Corvus006/JIF_Robot/paper/pictures/SchaltplanUpdate.png

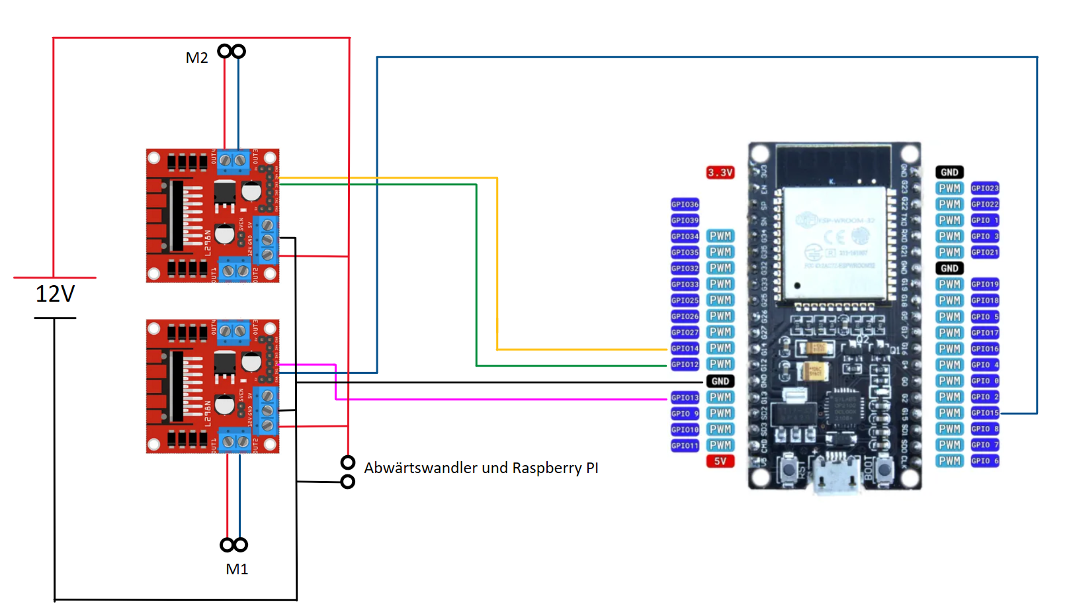
paper/pictures/SchaltplanUpdate.png
