Corvus006/JIF_Robot/paper/pictures/Schaltplan.png

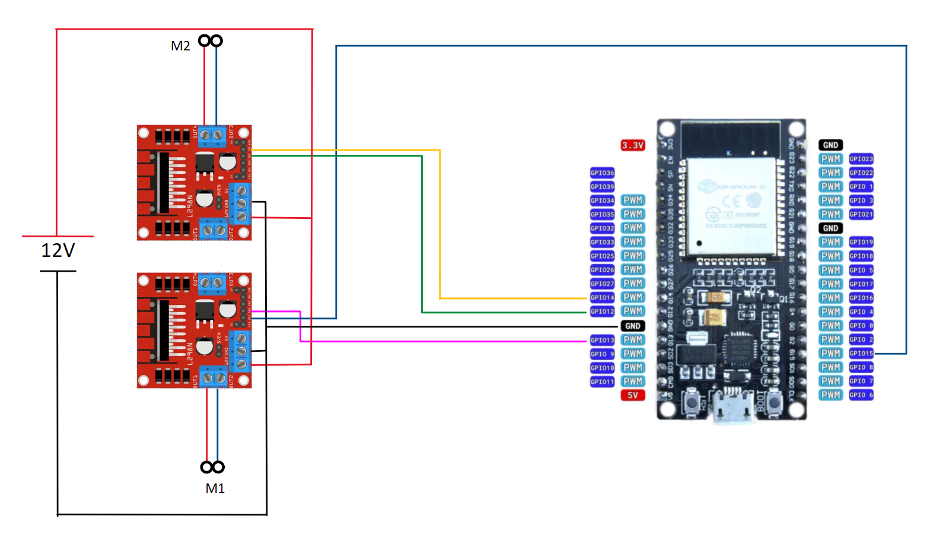
paper/pictures/Schaltplan.png
