Corvus006/JIF_Robot/CAD/3D Printable JIF- RC Tank v7.step

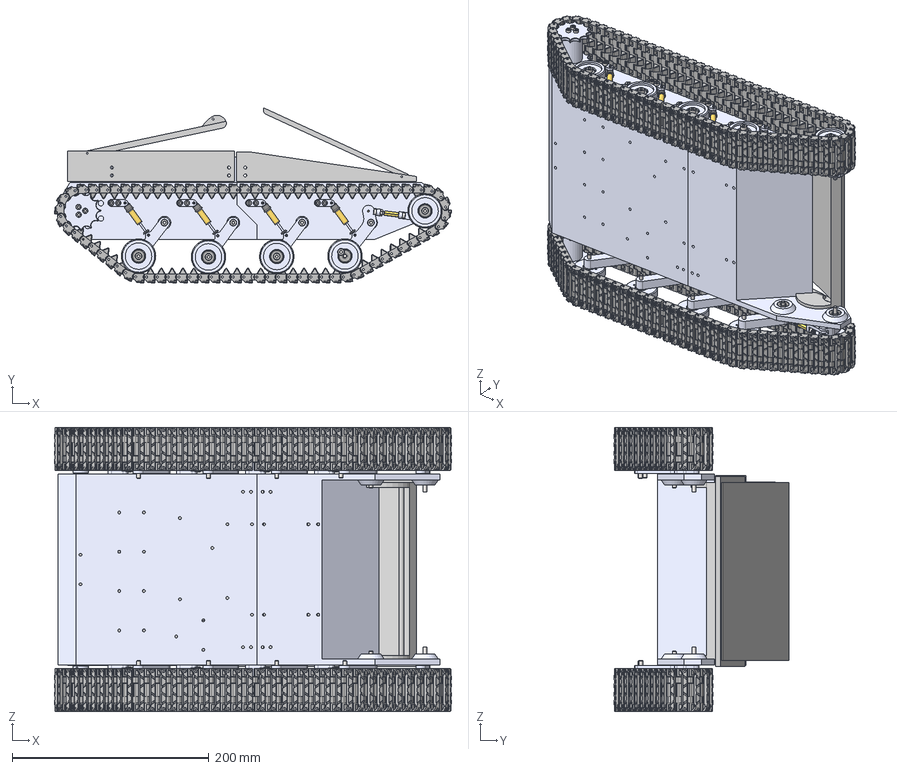
[picture p5: CAD file, 2024-01-28]
CAD/3D Printable JIF- RC Tank v7.step
403.7 x 178.2 x 289.0 mm
Road wheel arm 1r1 x 2
Shock Absorber - part 1r1 x 8
Shock Absorber - part 2r1 x 8
Bracket for Shock Absorberr1 x 8
Road wheel armr1 x 6
Track v3r1 x 158
Ball Bearing- 6x13x5mm h1r1_Ball Bearing 608 - 8x22x7mm x 6
DIN 912 M4 x 25 --- 25N_DIN 912 M4 x 25 --- 25N x 10
DIN 912 M3 x 20 --- 20N_DIN 912 M3 x 20 --- 20N x 22
DIN 912 M1.4 x 10 --- 10N_DIN 912 M1.4 x 10 --- 10N x 16
Road wheel - part 1r1 x 10
Road wheel - part 2r1 x 10
Ball Bearing- 4x13x5mm h1r1_Ball Bearing 608 - 8x22x7mm x 20
DIN 912 M4 x 40 --- 20N_DIN 912 M4 x 40 --- 20N x 8
DC Motor 12V - A37RGr1 x 2
Sprocket 12 teeth - part1r1 x 2
Sprocket 12 teeth - part2r1 x 2
Sprocket coupler for 6mm shaftr1 x 2
Track tensioner link 1r1 x 2
Track tensioner link 3r1 x 2
Track tensioner link 2r1 x 2
DIN 912 M3 x 16 --- 16N_DIN 912 M3 x 16 --- 16N x 2
DIN 912 M3 x 8 --- 8N_DIN 912 M3 x 8 --- 8N x 2
Distance nutr1 x 2
Hexagon Nut ISO 4032 - M3 - W - N_Hexagon Nut ISO 4032 - M3 - W - N x 2
DIN 912 M4 x 35 --- 20N_DIN 912 M4 x 35 --- 20N x 2
Pin d2mm l9mmr1 x 4
M4 Locknutr1 x 2
DIN 912 M3 x 10 --- 10N_DIN 912 M3 x 10 --- 10N x 7
Holes coverr1 x 14
Washer 4.3x9r1 x 6
Robot chassis - section 1r1
Robot chassis - section 2r1
Bracker 2r1 x 2
Bracket 3r1 x 2
Bracket 4r1 x 2
Komponente1
JIFMOtotreiberadapter
Komponente1_1
Komponente2
Akkuhalterung2.0
Komponente1_2
Komponente2_1
